kir486680/Open-Science-Bot/Electrical/AtopilePCB/README.md

# sdl_breakout

PCB module for sdl_breakout
