kir486680/Open-Science-Bot/Electrical/AtopilePCB/87606-408LF/README.md

# 87606_408lf

PCB module for 87606_408lf
