kir486680/Open-Science-Bot/Electrical/AtopilePCB/C0603C104M5RACTU/README.md

# c0603c104m5ractu

PCB module for c0603c104m5ractu
