kir486680/Open-Science-Bot/Electrical/AtopilePCB/C25YXJ100M5X11/README.md

# 25yxj100m5x11

PCB module for 25yxj100m5x11
