kir486680/Open-Science-Bot/Electrical/AtopilePCB/CL31B106KOHNNWE/README.md

# cl31b106kohnnwe

PCB module for cl31b106kohnnwe
