kir486680/Open-Science-Bot/Electrical/AtopilePCB/L150060GS75000/README.md

# 150060gs75000

PCB module for 150060gs75000
