kir486680/Open-Science-Bot/Electrical/AtopilePCB/UHE1E471MPD6/README.md

# uhe1e471mpd6

PCB module for uhe1e471mpd6
