kir486680/Open-Science-Bot/images/FullCircuit.jpeg

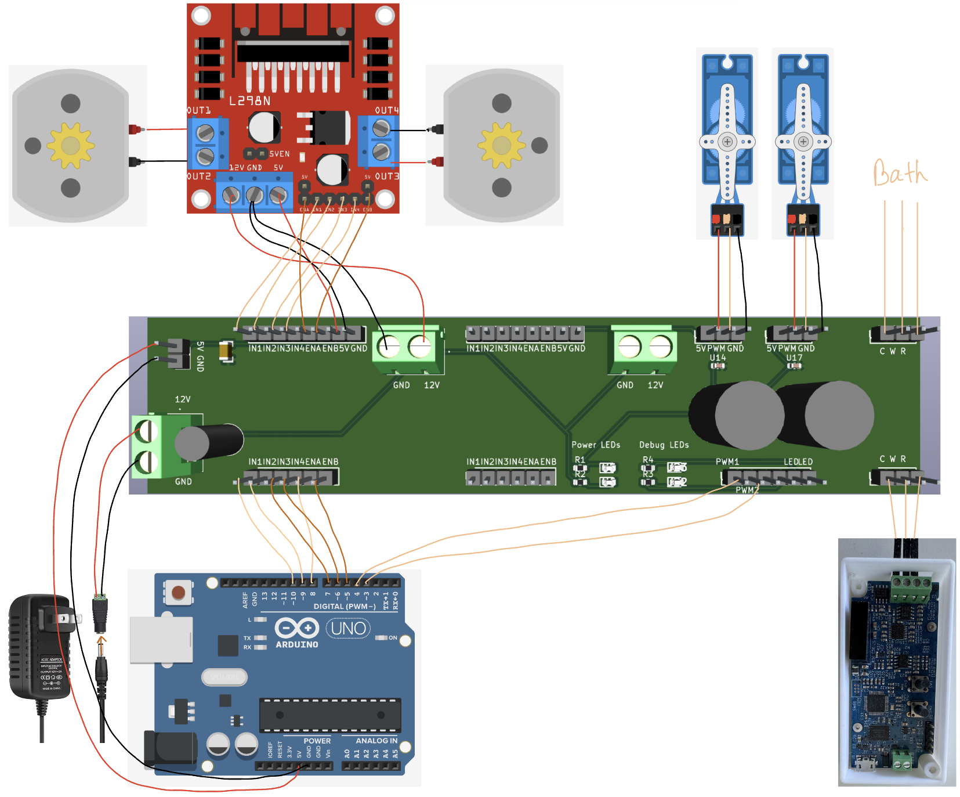
images/FullCircuit.jpeg
