kir486680/Open-Science-Bot/images/PCBImage.png

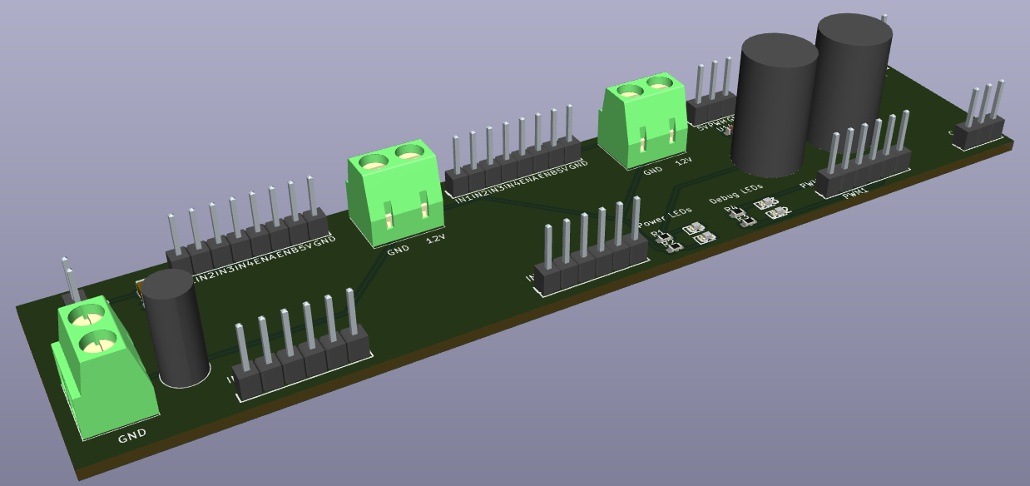
images/PCBImage.png
