kir486680/Open-Science-Bot/Mechanical/images/Bath_2.JPG

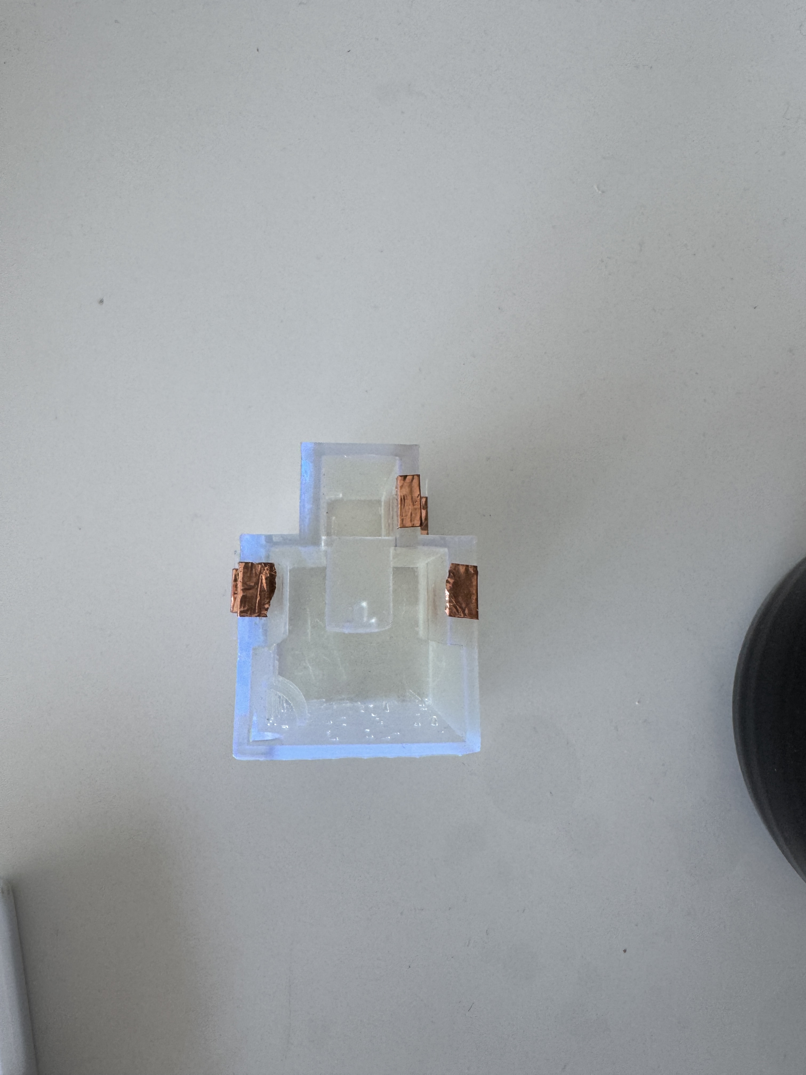
Mechanical/images/Bath_2.JPG
