kir486680/Open-Science-Bot/Mechanical/images/Electrode_Deposite.JPG

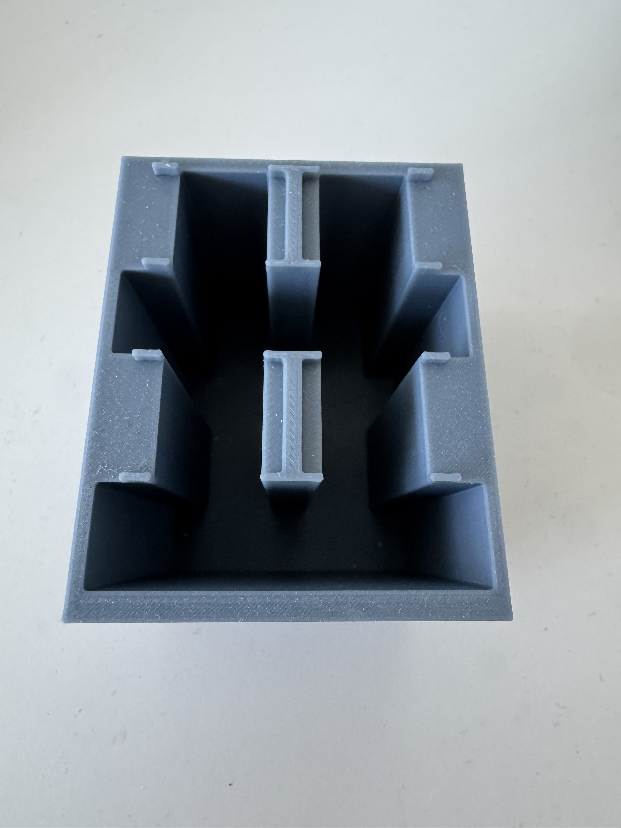
Mechanical/images/Electrode_Deposite.JPG
