kir486680/Open-Science-Bot/Mechanical/Electrodes Holder/Electrode Holder Assem.SLDASM

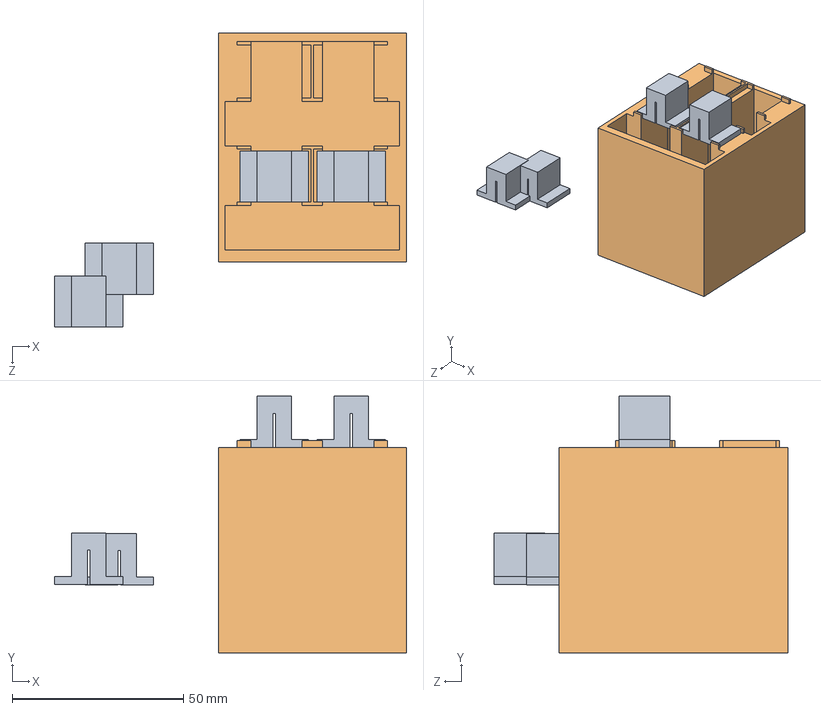
[picture p18: CAD file, 2025-03-10]
Mechanical/Electrodes Holder/Electrode Holder Assem.SLDASM
102.9 x 75.0 x 86.0 mm
Electrode Holder
Working Lid x 4
