kir486680/Open-Science-Bot/Mechanical/Gripper Redesign/Full Housing Front.SLDPRT

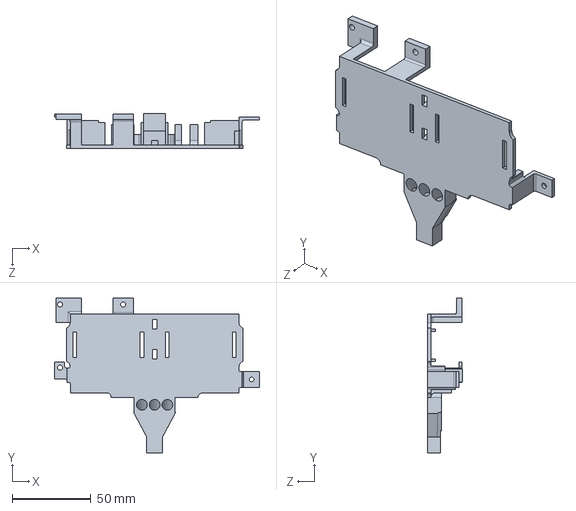
[picture p19: CAD file, 2025-03-10]
Mechanical/Gripper Redesign/Full Housing Front.SLDPRT
130.0 x 98.0 x 22.0 mm
