kir486680/Open-Science-Bot/Mechanical/Gripper Redesign/Full Housing Back.SLDPRT

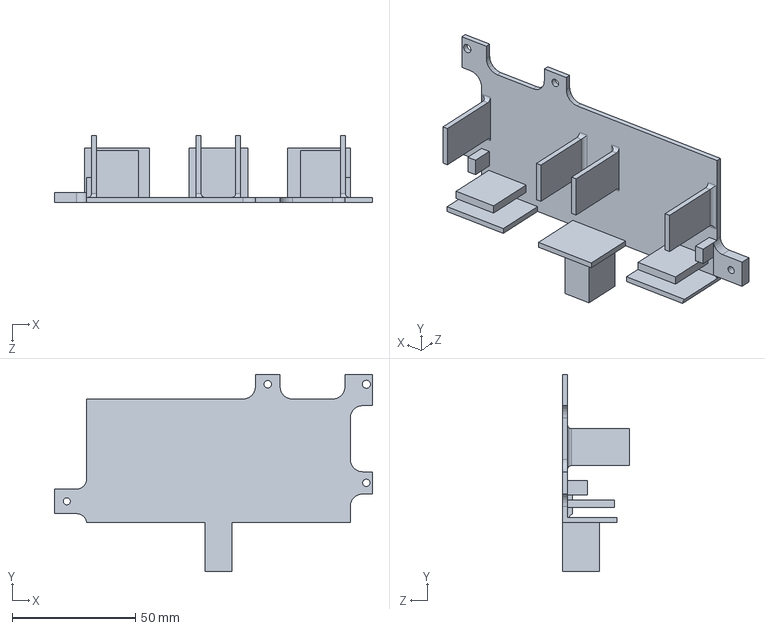
[picture p20: CAD file, 2025-03-10]
Mechanical/Gripper Redesign/Full Housing Back.SLDPRT
129.0 x 80.0 x 27.0 mm
