kir486680/Open-Science-Bot/Mechanical/Bath/Guide Assem.SLDASM

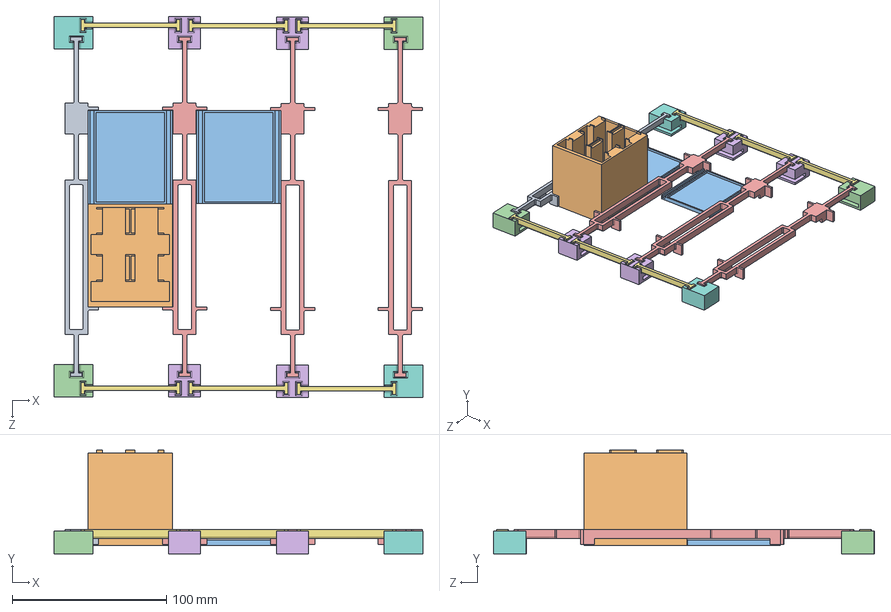
[picture p21: CAD file, 2025-03-10]
Mechanical/Bath/Guide Assem.SLDASM
239.0 x 67.4 x 247.1 mm
Guide Corner Clips x 2
Guide Sticks x 6
Guide Center Clips x 4
Guide Separators x 3
Guide Corner Clips Mirrored x 2
Bath Mount x 2
Electrode Holder
Guide Separators Side
