kir486680/Open-Science-Bot/Mechanical/Bath/Guide Corner Clips Mirrored Tight Corner.SLDPRT

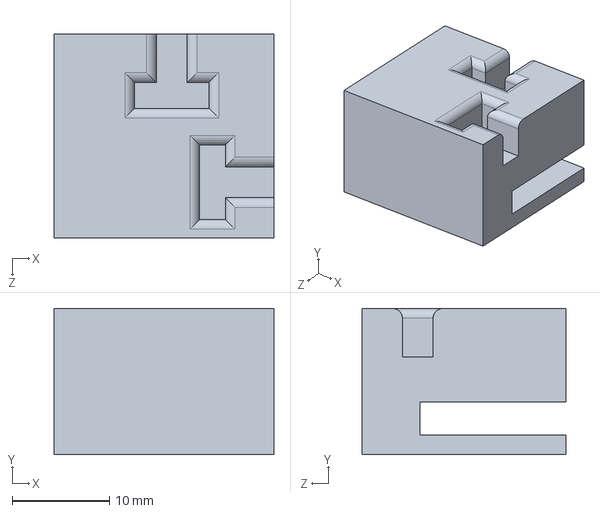
[picture p22: CAD file, 2025-03-10]
Mechanical/Bath/Guide Corner Clips Mirrored Tight Corner.SLDPRT
22.6 x 15.0 x 21.0 mm
