kir486680/Open-Science-Bot/Mechanical/Bath/Guide STL/Bed Heater Corner Holder.STL

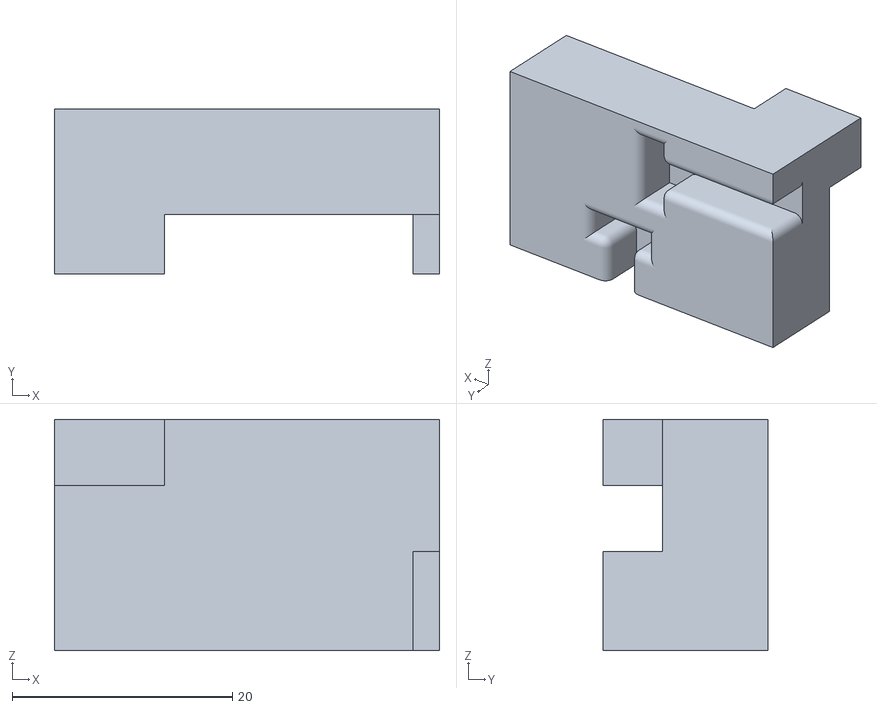
[picture p23: CAD file, 2025-03-10]
Mechanical/Bath/Guide STL/Bed Heater Corner Holder.STL
35.0 x 15.0 x 21.0
