kir486680/Open-Science-Bot/Mechanical/Electrodes Holder/Electrode Holder.SLDPRT

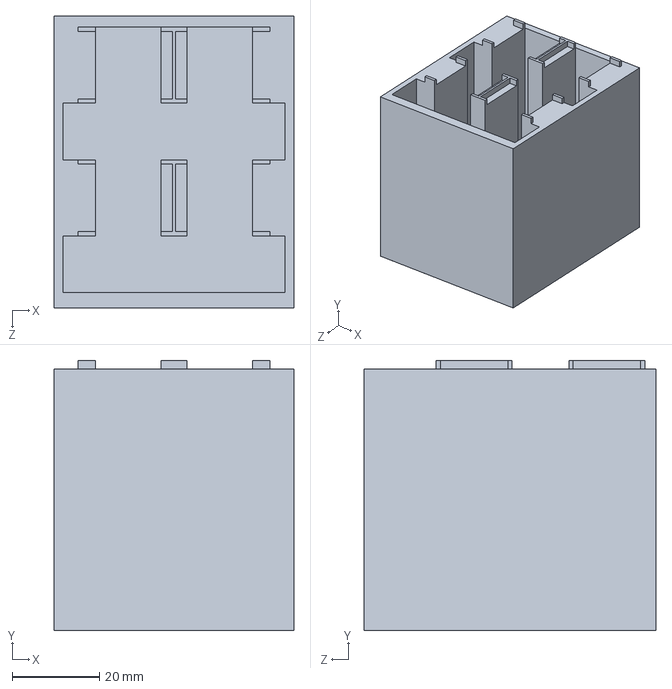
[picture p24: CAD file, 2025-03-10]
Mechanical/Electrodes Holder/Electrode Holder.SLDPRT
55.0 x 62.0 x 67.0 mm
