kir486680/Open-Science-Bot/Mechanical/Gripper Redesign/Gears/Rack Gear.SLDPRT

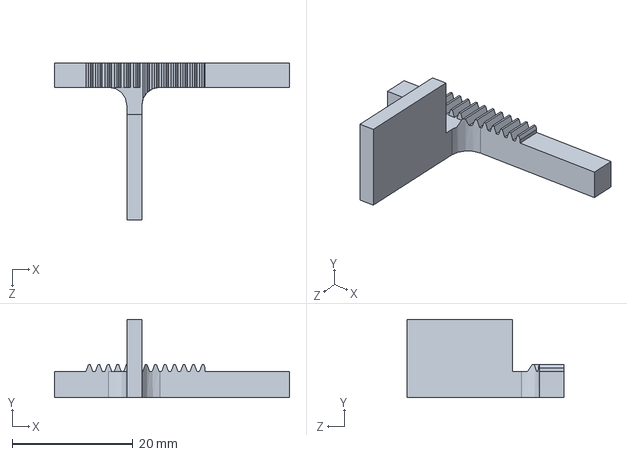
[picture p25: CAD file, 2025-03-10]
Mechanical/Gripper Redesign/Gears/Rack Gear.SLDPRT
39.0 x 13.0 x 26.0 mm
