kir486680/Open-Science-Bot/Mechanical/Bath/Guide Center Clips.SLDPRT

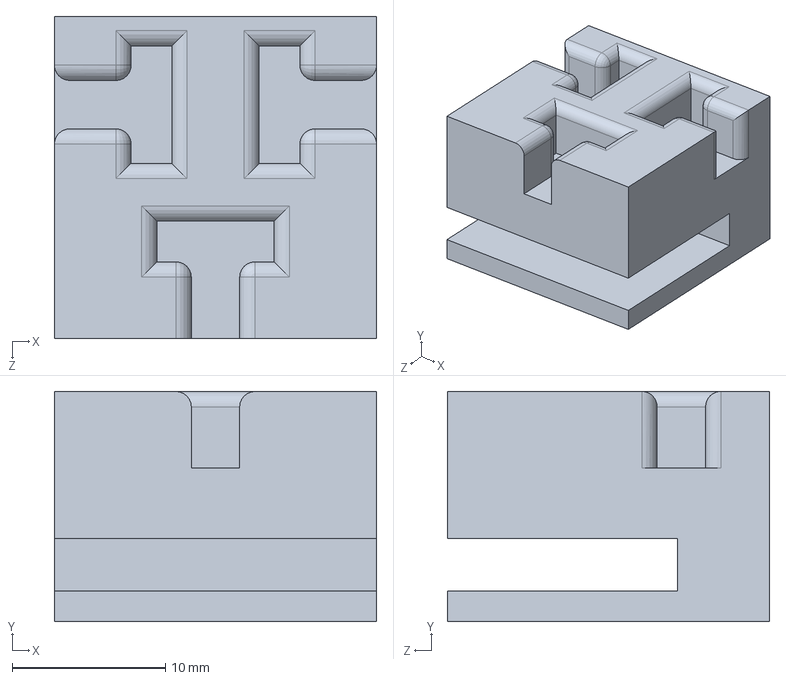
[picture p27: CAD file, 2025-03-10]
Mechanical/Bath/Guide Center Clips.SLDPRT
21.0 x 15.0 x 21.0 mm
