kir486680/Open-Science-Bot/Mechanical/Bath/Guide STL/Guide Corner Clips.STL

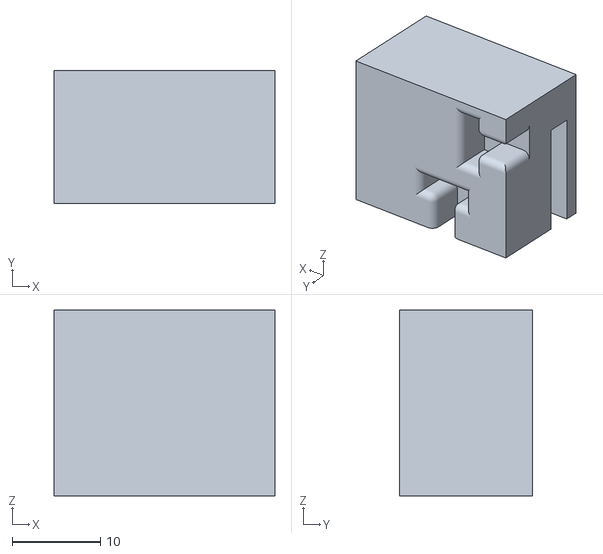
[picture p28: CAD file, 2025-03-10]
Mechanical/Bath/Guide STL/Guide Corner Clips.STL
25.0 x 15.0 x 21.0
