kir486680/Open-Science-Bot/Mechanical/Gripper Redesign/Lid/Larger Circular Electrode Lid.SLDPRT

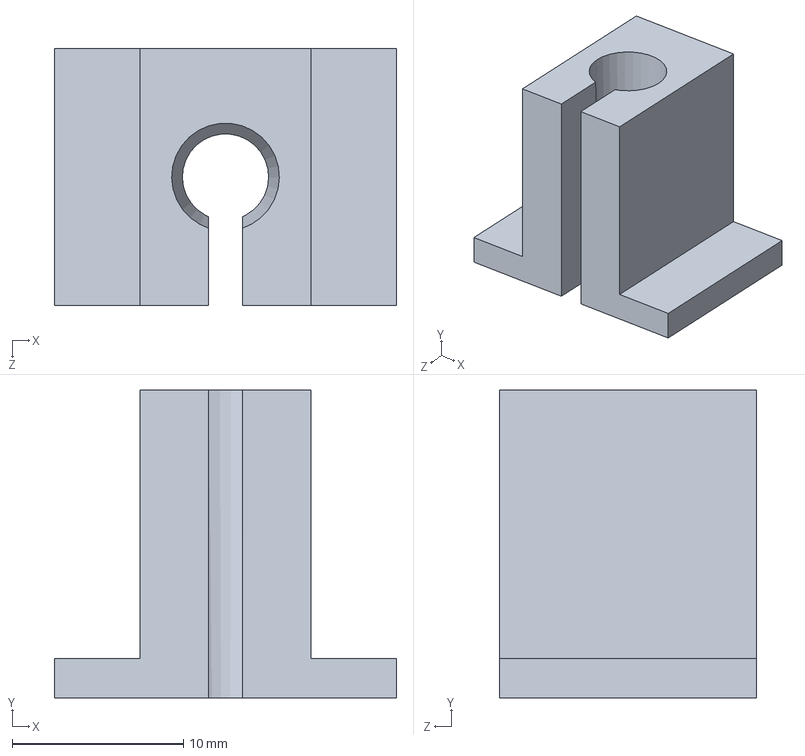
[picture p29: CAD file, 2025-03-10]
Mechanical/Gripper Redesign/Lid/Larger Circular Electrode Lid.SLDPRT
20.0 x 18.0 x 15.0 mm
