kir486680/Open-Science-Bot/Mechanical/Bath/Guide STL/Guide Separators.STL

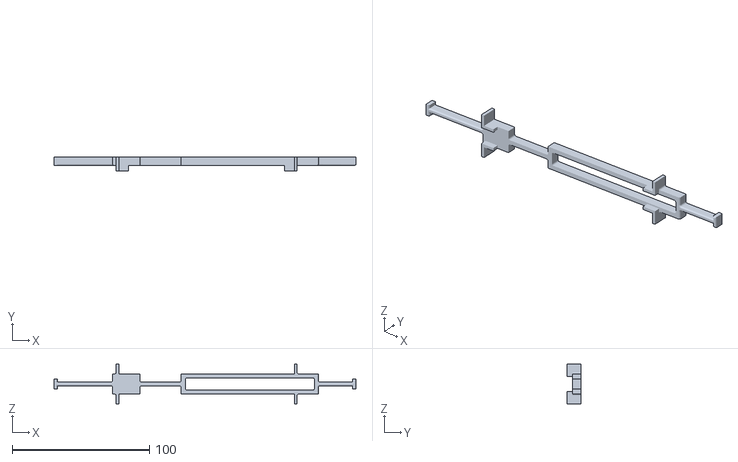
[picture p30: CAD file, 2025-03-10]
Mechanical/Bath/Guide STL/Guide Separators.STL
220.1 x 10.0 x 28.9
