kir486680/Open-Science-Bot/Mechanical/Gripper Redesign/Gears/Spur Gear.SLDPRT

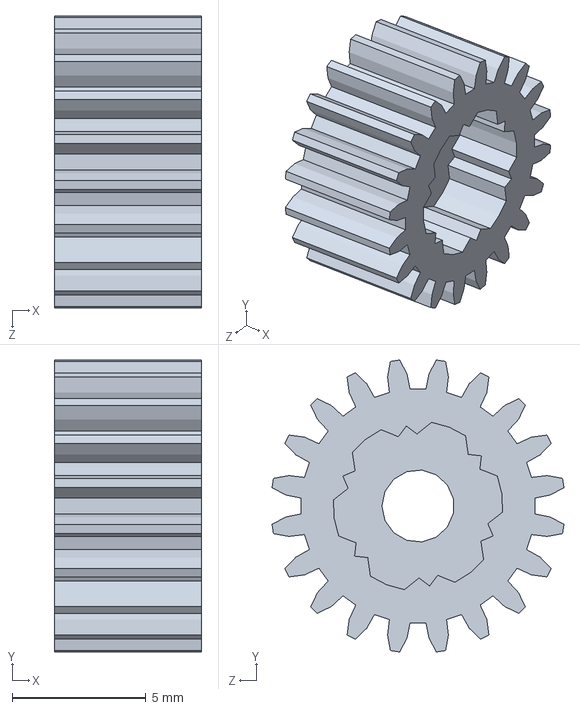
[picture p31: CAD file, 2025-03-10]
Mechanical/Gripper Redesign/Gears/Spur Gear.SLDPRT
5.50 x 10.9 x 10.9 mm
