kir486680/Open-Science-Bot/Mechanical/Gripper Redesign/Lid/Larger Reference Circular Electrode Lid.SLDPRT

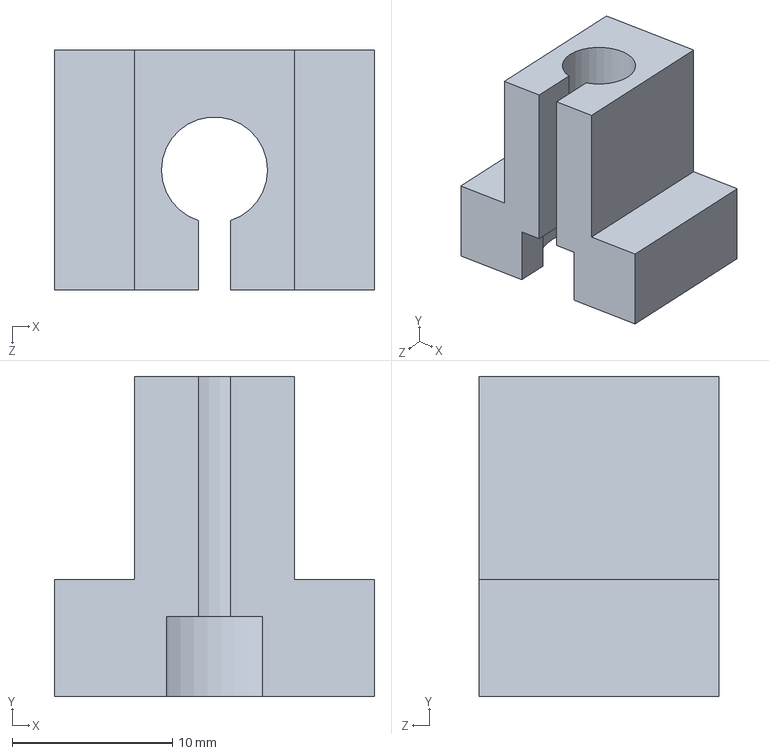
[picture p32: CAD file, 2025-03-10]
Mechanical/Gripper Redesign/Lid/Larger Reference Circular Electrode Lid.SLDPRT
20.0 x 20.0 x 15.0 mm
