kir486680/Open-Science-Bot/Mechanical/Bath/Guide STL/Guide Separators Side.STL

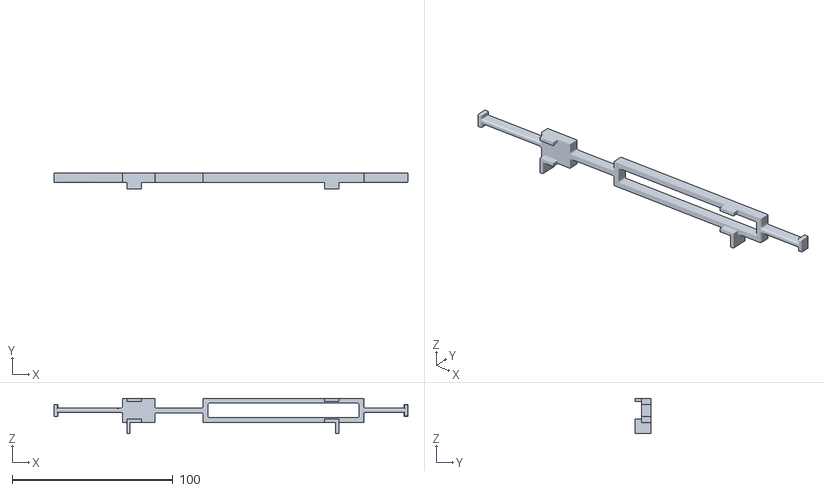
[picture p33: CAD file, 2025-03-10]
Mechanical/Bath/Guide STL/Guide Separators Side.STL
220.1 x 10.0 x 21.9
