kir486680/Open-Science-Bot/Mechanical/Gripper Redesign/Lid/Smaller Working Electrode Lid.SLDPRT

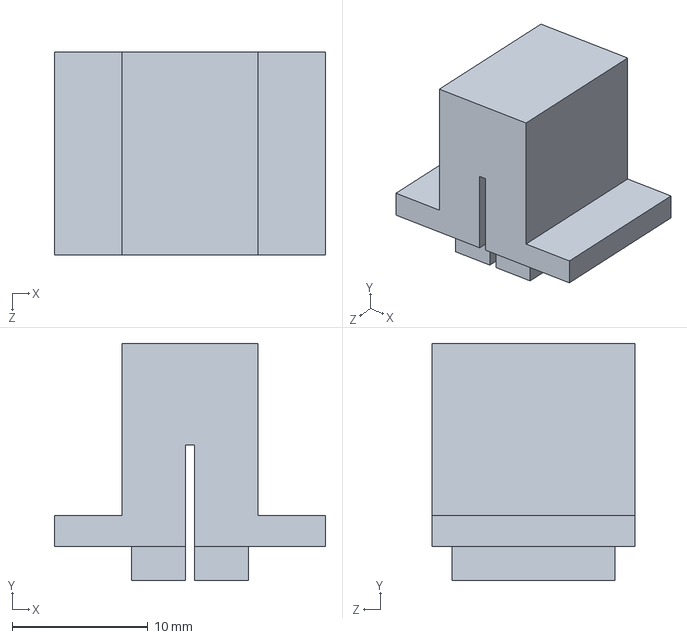
[picture p34: CAD file, 2025-03-10]
Mechanical/Gripper Redesign/Lid/Smaller Working Electrode Lid.SLDPRT
20.0 x 17.5 x 15.0 mm
