kir486680/Open-Science-Bot/Mechanical/Gripper Redesign/Lid/Working Lid.SLDPRT

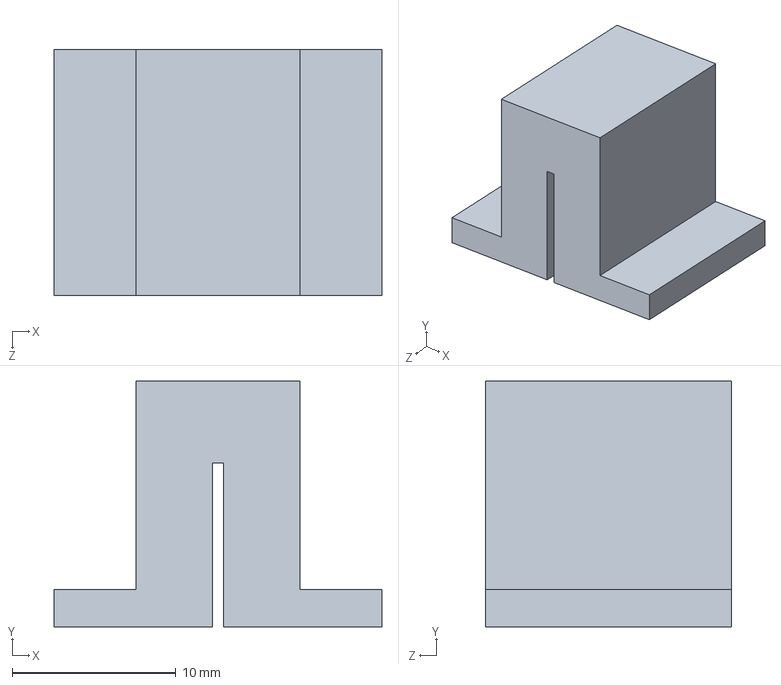
[picture p35: CAD file, 2025-03-10]
Mechanical/Gripper Redesign/Lid/Working Lid.SLDPRT
20.0 x 15.0 x 15.0 mm
