kir486680/Open-Science-Bot/Mechanical/Bath/Guide STL/Guide Sticks.STL

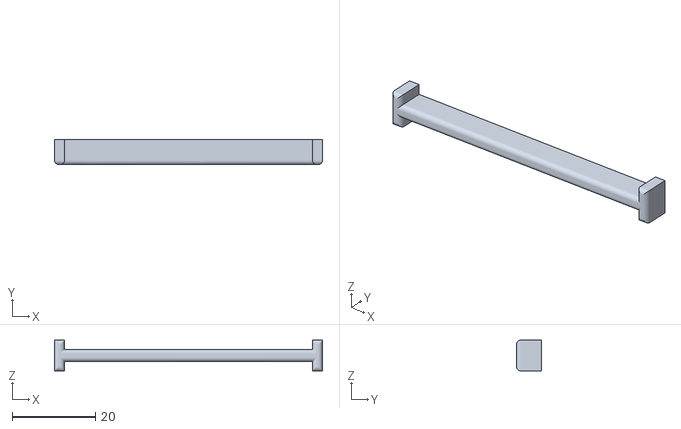
[picture p36: CAD file, 2025-03-10]
Mechanical/Bath/Guide STL/Guide Sticks.STL
64.3 x 6.00 x 7.40
