kir486680/Open-Science-Bot/Mechanical/Bath/Bath V2.SLDPRT

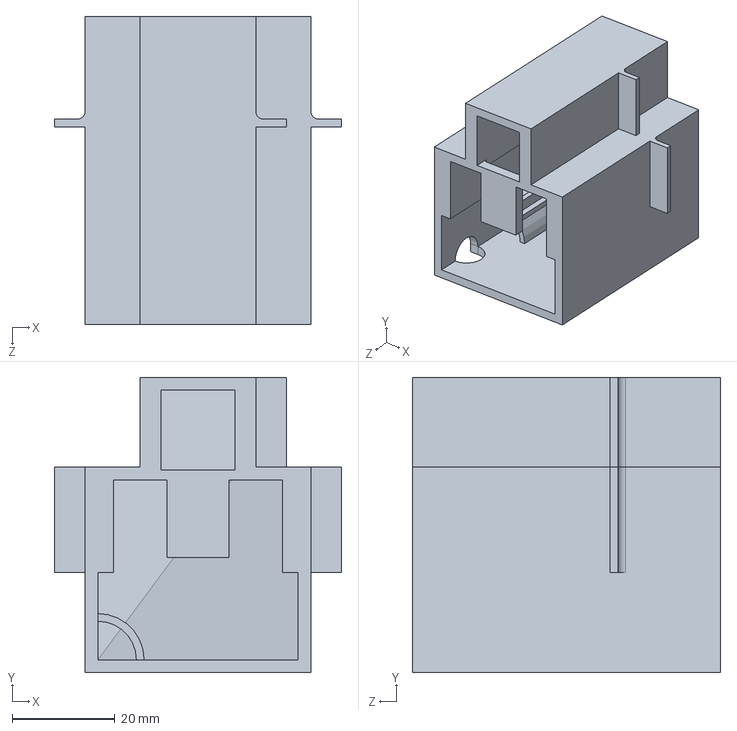
[picture p37: CAD file, 2025-03-10]
Mechanical/Bath/Bath V2.SLDPRT
56.0 x 57.5 x 60.0 mm
