kir486680/Open-Science-Bot/Mechanical/Bath/Guide STL/Bath Mount.STL

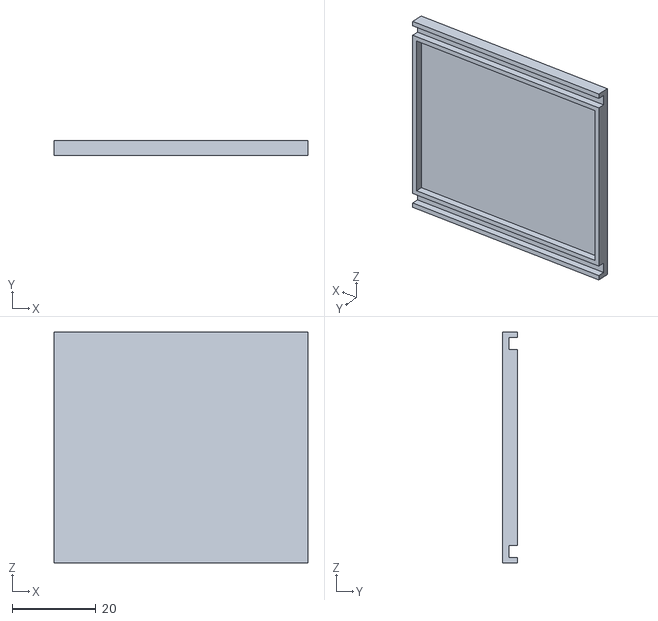
[picture p38: CAD file, 2025-03-10]
Mechanical/Bath/Guide STL/Bath Mount.STL
60.5 x 3.50 x 55.0
