kir486680/Open-Science-Bot/Mechanical/Gripper Redesign/Full Head Assembly.SLDASM

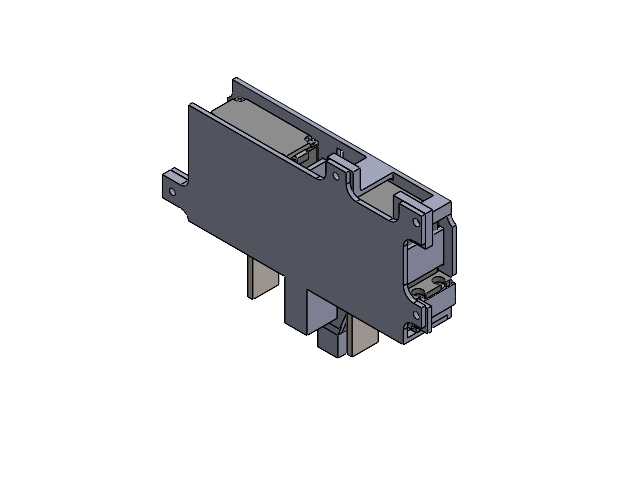
[picture p39: CAD file, 2025-03-10]
Mechanical/Gripper Redesign/Full Head Assembly.SLDASM
Full Housing Part 1
_HS-322HD.stp x 2
Rack Gear Mirrored
Rack Gear
Full Housing Part 2
spur gear_am x 2
