kir486680/Open-Science-Bot/(list of files, cad)

Other CAD files:
Mechanical/Gripper Redesign/Full Housing Front 3 Pump.STL
Mechanical/Gripper Redesign/Full Housing Back UI Modification.STL
Mechanical/Gripper Redesign/PrinterMount.sldprt
Mechanical/Gripper Redesign/Gears/Rack Gear Mirrored.SLDPRT
Mechanical/Bath/Guide Corner Clips.SLDPRT
Mechanical/Bath/Bed Heater Corner Holder.SLDPRT
Mechanical/Bath/Guide Separators Side.SLDPRT
Mechanical/Bath/Guide STL/Guide Corner Clips Mirrored Tight Corner.STL
Mechanical/Bath/Guide STL/Guide Corner Clips Mirrored.STL
Mechanical/Bath/Guide Corner Clips Mirrored.SLDPRT
Mechanical/Bath/Bath Mount.SLDPRT
Mechanical/Bath/Guide STL/Guide Center Clips.STL
Mechanical/Bath/Guide Sticks.SLDPRT
Mechanical/Bath/Guide Separators.SLDPRT
Mechanical/Bath/Bath V2.STL
Mechanical/Electrodes Holder/Electrode Holder.STL
