kir486680/Open-Science-Bot/(threads)

Thread 5 (2023-06-09):

Fix pwm of the gripper. Deadline: June 14th

jaegpark, 2023-06-09:
1. Look into how PWM works
2. Change the current code for the gripper

CTchani, 2023-06-13:
PWM works. Gripper is kinda broken.

Closed 2023-06-13.

Thread 6 (2023-06-09):

Fix the negative y axis movement. Deadline June 14th.

jaegpark, 2023-06-09:

Closed 2023-06-13.

Thread 8 (2023-06-12):

Make sure you can build the project with picamera on non-raspi machines

kir486680, 2023-06-12:
When you try to install picamera on a machine which is not raspi, you get "raise ValueError('Unable to determine if this system is a Raspberry Pi')" We gotta allow people build project without this.

jaegpark, 2023-06-12:
this is a good issue, will work on it today

jaegpark, 2023-06-13:
#9

jaegpark, 2023-06-14:
Fixed with #9

Closed 2023-06-14.
