kir486680/Open-Science-Bot/Electrical/AtopilePCB/elec/layout/default/sdl_breakout.kicad_pcb

## KiCad design Electrical/AtopilePCB/elec/layout/default/sdl_breakout.kicad_pcb (2025-03-12)

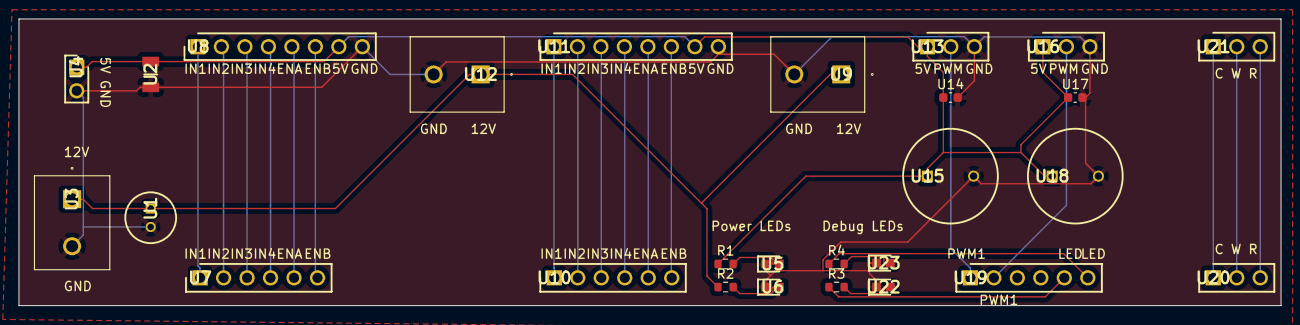
[picture p40: board sdl_breakout.kicad_pcb from above]

Board: 2 copper layers, 136.5 x 31.0 mm, 27 parts (0 on the bottom side), 26 nets.

Parts:
R1, R3, R4: 100mW Thick Film Resistors 75V ±100ppm/℃ ±1% 390Ω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; R0603
R2: 100mW Thick Film Resistors 75V ±100ppm/℃ ±1% 1.8k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; R0603
U1: Rubycon 100uF 25 V dc Aluminium Electrolytic Capa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; CAPPRD200W50D550H1250
U2: Cap Ceramic 10uF 16V X7R 10% Pad SMD 1206 125C T/R; CAPC3216X180N
U3, U9, U12: PCB terminal block, nominal current: 13.5 A, rate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; 1729128
U4: CONN HEADER VERT 2POS 2.54MM; HDRV2W64P0X254_1X2_508X250X850P
U5, U6, U22, U23: Wurth Elektronik WL-SMCW 520 nm Green LED, 1608 (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; LEDC1608X80N
U7, U10, U19: CONN HEADER VERT 6POS 2.54MM; HDRV6W64P0X254_1X6_1524X250X952P
U8, U11: Conn Unshrouded Header HDR 8 POS 2.54mm Solder ST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; HDRV8W64P0X254_1X8_2032X250X888P
U13, U16, U20, U21: CONN HEADER VERT 3POS 2.54MM; HDRV3W64P0X254_1X3_762X250X952P
U14, U17: SMD Comm X7R, Ceramic, 0.1 uF, 20%, 50 VDC, 125 V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; C0603
U15, U18: Nichicon 470F 25V dc Aluminium Electrolytic Capac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; CAPPRD500W60D1025H1750

Connections:
counter: U20.1, U21.1
debug_led_1.ic-p2: R3.2, U22.2
debug_led_2.ic-p2: R4.2, U23.2
digital5: R3.1, U19.5
digital6: R4.1, U19.6
gnd: U1.2, U2.2, U3.2, U4.2, U5.1, U6.1, U8.8, U9.2, U11.8, U12.2, U13.3, U14.2, U15.2, U16.3, U17.2, U18.2, U22.1, U23.1
motor1-ena: U7.5, U8.5
motor1-enb: U7.6, U8.6
motor1-in1: U7.1, U8.1
motor1-in2: U7.2, U8.2
motor1-in3: U7.3, U8.3
motor1-in4: U7.4, U8.4
motor2-ena: U10.5, U11.5
motor2-enb: U10.6, U11.6
motor2-in1: U10.1, U11.1
motor2-in2: U10.2, U11.2
motor2-in3: U10.3, U11.3
motor2-in4: U10.4, U11.4
power_led_5v.ic-p2: R1.2, U5.2
power_led_12v.ic-p2: R2.2, U6.2
reference: U20.3, U21.3
servo1-control: U13.2, U19.1
servo2-control: U16.2, U19.2
vcc: R2.1, U1.1, U3.1, U9.1, U12.1
vcc-1: R1.1, U2.1, U4.1, U8.7, U11.7, U13.1, U14.1, U15.1, U16.1, U17.1, U18.1
working: U20.2, U21.2
