kir486680/Open-Science-Bot/Software/main.py

from Printer import Printer
from Arduino import ArduinoDevice
from Potentiostat import PotentiostatDevice
from TaskManager import TaskManager
import logging
from Device import DeviceFactory, DeviceType
from RobotSequences import RobotSequences

logging.basicConfig(level=logging.INFO)

def main():
    DeviceFactory.register_device(DeviceType.PRINTER, Printer)
    DeviceFactory.register_device(DeviceType.ARDUINO, ArduinoDevice)
    DeviceFactory.register_device(DeviceType.POTENTIOSTAT, PotentiostatDevice)

    DeviceFactory.load_config('devices.json')

    printer = DeviceFactory.create_device(DeviceType.PRINTER)
    arduino = DeviceFactory.create_device(DeviceType.ARDUINO)
    potentiostat = DeviceFactory.create_device(DeviceType.POTENTIOSTAT)

    task_manager = TaskManager()

    robot_sequences = RobotSequences(task_manager, printer, arduino, potentiostat)

    # Example sequence
    try:
        #robot_sequences.home_robot()
        
        # Wait for user to set up bath and electrodes
        #robot_sequences.wait_for_user_confirmation()
        
        robot_sequences.move_to_start()
        robot_sequences.grip_electrodes()
        robot_sequences.move_to_bath()
        
        # # Pump operations with calibrated volumes
        #robot_sequences.pump_A_forward(10.0)  # Pump 10mL with pump A
        #robot_sequences.pump_B_forward(50.0)  # Pump 15mL with pump B
        
        # # Run an electrochemical test
        # sample_name = "test_sample"
        # robot_sequences.run_electrochemical_sequence(sample_name)
        
        # robot_sequences.ungrip_both_electrodes()
        # robot_sequences.retract_head()
    finally:
        # Clean up
        if potentiostat:
            potentiostat.disconnect()

if __name__ == "__main__":
    main()
