kir486680/Open-Science-Bot/(commit log)

2025-03-10 Added Parts
    [Bath Mount.SLDPRT, Bath Mount.STL, Bath V2.SLDPRT, Bath V2.STL, Bath and Lid Assem.SLDASM, Bath.SLDPRT, Bed Heater Corner Holder.SLDPRT, Bed Heater Corner Holder.STL]
2025-03-12 adding electrical stuff
    [Bath Mount.SLDPRT, Bath Mount.STL, Bath V2.SLDPRT, Bath V2.STL, Bath and Lid Assem.SLDASM, Bath.SLDPRT, Bed Heater Corner Holder.SLDPRT, Bed Heater Corner Holder.STL]
2025-03-12 pushing new electrical and mechanical stuff
    [150060GS75000.step, 150060gs75000.kicad_pcb, 150060gs75000.kicad_sch, 1729128.kicad_pcb, 1729128.kicad_sch, 1729128.step, 25YXJ100M5X11.step, 25yxj100m5x11.kicad_pcb]
2025-04-17 Adding more docs, images, etc...
    [87606-408LF.step, 87606_408lf.kicad_pcb, 87606_408lf.kicad_sch, PRT-09280.step, prt_09280.kicad_pcb, prt_09280.kicad_sch]
2025-04-20 Adding Mechanical Documentation
    [Bath.SLDPRT, Gripper Clamp 23.85mm.STL, Gripper Clamp Part 2 24mm.STL, Gripper Clamp Part 2.SLDPRT, Gripper Clamp.SLDPRT, Holder.SLDASM, Housing Part 1.SLDPRT, Housing Part 2.SLDPRT]
2025-05-11 Removed Files and Updated Readme
    [Bath and Lid Assem.SLDASM, C24T Spline Test Tighter Fit.SLDPRT, C24T Spline Test.SLDPRT, Shorter Guide Sticks.SLDPRT]
2025-05-25 Adding Calibration and Bayesian Optimization
2025-05-29 cleaning up the files strucuture
    [150060GS75000.step, 150060gs75000.kicad_pcb, 150060gs75000.kicad_sch, 1729128.kicad_pcb, 1729128.kicad_sch, 1729128.step, 25YXJ100M5X11.step, 25yxj100m5x11.kicad_pcb]
2025-06-03 adding new main
    [150060GS75000.step, 150060gs75000.kicad_pcb, 1729128.kicad_pcb, 1729128.step, 25YXJ100M5X11.step, 25yxj100m5x11.kicad_pcb, C0603C104M5RACTU.step, CL31B106KOHNNWE.step]
2025-06-03 refactoring electrical
    [150060gs75000.kicad_sch, 1729128.kicad_sch, 25yxj100m5x11.kicad_sch, c0603c104m5ractu.kicad_sch, cl31b106kohnnwe.kicad_sch, ph1_02_ua.kicad_sch, ph1_03_ua.kicad_sch, ph1_06_ua.kicad_sch]
2025-06-03 Adding electrical files again
    [150060GS75000.step, 150060gs75000.kicad_pcb, 150060gs75000.kicad_sch, 1729128.kicad_pcb, 1729128.kicad_sch, 1729128.step, 25YXJ100M5X11.step, 25yxj100m5x11.kicad_pcb]
2025-06-08 Added Printer Mount
    [PrinterMount.sldprt]
2025-06-16 fixinf gantry and adding docs
